Clement-Cardot/PS-2-Keylogger/README.md

# PS-2-Keylogger

Video de présentation du projet :
https://youtu.be/JonzK1D9_OE

Il s'agit d'un projet de KeyLogger Harware permettant le piratage d'un clavier PS/2
