Clement-Cardot/PS-2-Keylogger/PCB/eurocircuits.com.png

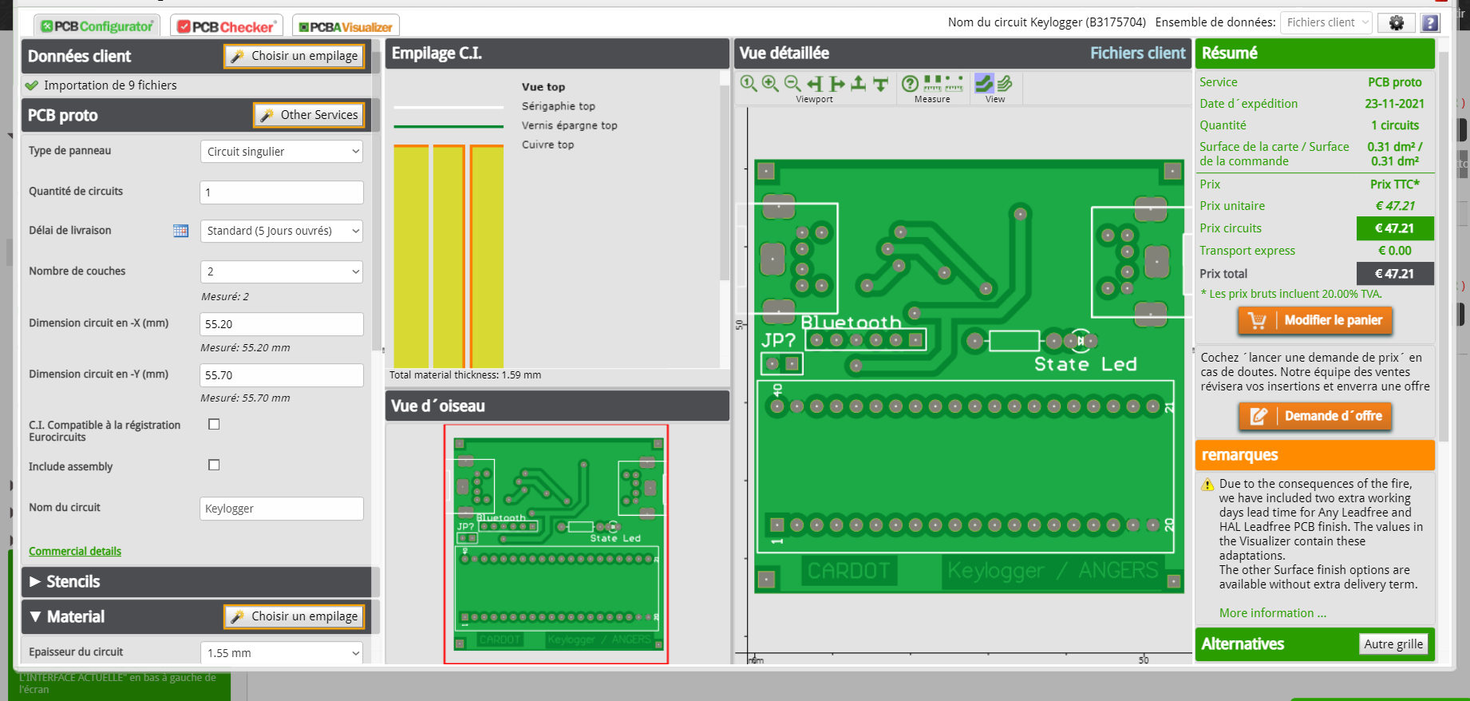
PCB/eurocircuits.com.png
