Clement-Cardot/PS-2-Keylogger/(list of files, drawings)

Other design files:
PCB/E3_DEEP_A2_ANGERS_CARDOT.PCBDOC
