Clement-Cardot/PS-2-Keylogger/test.h

/*
 * test.h
 *
 *  Created on: 11 janv. 2022
 *      Author: Clement CARDOT
 */

#ifndef TEST_H_
#define TEST_H_

void test(void);
void toogleBlueLED(void);
void toogleRedLED(void);

#endif /* TEST_H_ */
